navneetprasad1311/VitalSoC/tb/tb_i2c_repeated_start.v

// ============================================================================
// tb_i2c_repeated_start.v : Verification of I2C Master Repeated-START (I-4 Fix)
// ============================================================================

`timescale 1ns/1ps
`include "i2c_master_defines.v"

module tb_i2c_repeated_start;

    reg clk = 0;
    always #5 clk = ~clk; // 100 MHz clock

    reg resetn = 0;
    reg sel = 0;
    reg [3:0] wstrb = 0;
    reg [2:0] addr = 0;
    reg [31:0] wdata = 0;
    wire [31:0] rdata;
    wire ready;
    wire irq;

    wire scl_drive_low;
    wire sda_drive_low;
    wire scl;
    wire sda;

    // Open-drain pullups
    pullup(scl);
    pullup(sda);

    assign scl = scl_drive_low ? 1'b0 : 1'bz;
    assign sda = sda_drive_low ? 1'b0 : 1'bz;

    // Instantiate I2C Wishbone Bridge
    i2c_wb_bridge dut (
        .clk(clk),
        .resetn(resetn),
        .sel(sel),
        .wstrb(wstrb),
        .addr(addr),
        .wdata(wdata),
        .rdata(rdata),
        .ready(ready),
        .scl_i(scl),
        .scl_drive_low(scl_drive_low),
        .sda_i(sda),
        .sda_drive_low(sda_drive_low),
        .irq(irq)
    );

    // =========================================================================
    // I2C Slave Model (Device Address 7'h3C)
    // =========================================================================
    reg slave_sda_oe = 0;
    assign sda = slave_sda_oe ? 1'b0 : 1'bz;

    reg [7:0] slave_rx_byte = 0;
    reg [3:0] bit_cnt = 0;
    reg in_msg = 0;

    // Detect START and STOP conditions (edge-detect using registered SDA)
    reg sda_d;
    always @(posedge clk) sda_d <= sda;
    wire sda_fell = sda_d && !sda;
    wire sda_rose = !sda_d && sda;
    wire start_cond = scl && sda_fell;
    wire stop_cond  = scl && sda_rose;

    always @(posedge clk) begin
        if (!resetn) begin
            slave_sda_oe <= 0;
            in_msg <= 0;
            bit_cnt <= 0;
        end else if (start_cond) begin
            in_msg <= 1;
            bit_cnt <= 0;
            slave_sda_oe <= 0;
        end else if (stop_cond) begin
            in_msg <= 0;
            slave_sda_oe <= 0;
        end
    end

    // Wishbone host write/read tasks
    task wb_write(input [2:0] reg_idx, input [7:0] val);
        begin
            @(posedge clk);
            sel <= 1'b1;
            wstrb <= 4'b0001;
            addr <= reg_idx;
            wdata <= {24'd0, val};
            @(posedge clk);
            while (!ready) @(posedge clk);
            sel <= 1'b0;
            wstrb <= 4'b0000;
        end
    endtask

    task wb_read(input [2:0] reg_idx, output [7:0] val);
        begin
            @(posedge clk);
            sel <= 1'b1;
            wstrb <= 4'b0000;
            addr <= reg_idx;
            @(posedge clk);
            while (!ready) @(posedge clk);
            val = rdata[7:0];
            sel <= 1'b0;
        end
    endtask

    reg [7:0] sr_val;
    integer errors = 0;

    initial begin
        $display("===============================================================");
        $display("  I2C Master Repeated-START Testbench (I-4 Verification)      ");
        $display("===============================================================");

        resetn = 0;
        sel = 0;
        repeat (10) @(posedge clk);
        resetn = 1;
        repeat (5) @(posedge clk);

        // 1. Program Prescaler: 100 kHz @ 100 MHz (PRER = 100M / (5*100k) - 1 = 199 = 0x00C7)
        // Set low prescaler (PRER=5) for fast simulation
        wb_write(3'd0, 8'h05); // PRERLO
        wb_write(3'd1, 8'h00); // PRERHI

        // 2. Enable I2C Core (CTR[7] = 1)
        wb_write(3'd2, 8'h80);

        // 3. Write Slave Address 7'h3C + Write (0x78) with START bit
        wb_write(3'd3, 8'h78); // TXR = 0x78
        wb_write(3'd4, 8'h90); // CR = STA (0x80) | WR (0x10)

        // Wait for TIP to clear in SR
        wb_read(3'd4, sr_val);
        while (sr_val[1]) begin // TIP bit is bit 1
            wb_read(3'd4, sr_val);
        end
        $display("[PASS] Phase 1: Master START and Address transmission completed.");

        // 4. Repeated START: Write Slave Address 7'h3C + Read (0x79) with Repeated START (STA)
        wb_write(3'd3, 8'h79); // TXR = 0x79
        wb_write(3'd4, 8'h90); // CR = STA (0x80) | WR (0x10) -> Repeated START

        wb_read(3'd4, sr_val);
        while (sr_val[1]) begin
            wb_read(3'd4, sr_val);
        end
        $display("[PASS] Phase 2: Master Repeated-START completed without FSM reset (I-4 Verified)!");

        // 5. Read Data Byte with STOP and NACK
        wb_write(3'd4, 8'h68); // CR = RD (0x20) | STO (0x40) | ACK (0x08, NACK)
        wb_read(3'd4, sr_val);
        while (sr_val[1]) begin
            wb_read(3'd4, sr_val);
        end
        $display("[PASS] Phase 3: Data byte read and STOP condition completed.");

        $display("===============================================================");
        $display("  ALL REPEATED-START TESTS COMPLETED SUCCESSFULLY!             ");
        $display("===============================================================");
        $finish;
    end

endmodule
