navneetprasad1311/VitalSoC/(notices)

Notices in the files:
rtl/i2c_master_top.v:
Copyright (C) 2001 Richard Herveille
